Jose-4625/LAMP-BOX-ECO/README.md

# LAMP-BOX-ECO
## Loop-mediated Isothermal Amplification focused diagnostic ecosystem
Devices:
* LAMP-VIS
  * 3D printed Visualization box
* LAMP-BOX
  * Low-cost reaction Vessel for LAMP reactions
