Jose-4625/LAMP-BOX-ECO/VisBox/README.md

# LAMP Visualization Box

## Components
* 3D printed components
    * CE3_lampBOX circuit tray v1.gcode (Ender 3 specific gcode)
    * Upiece.stl
    * lampBOX circuit tray v1.stl
    * slider.stl
    * VisBox.stl
* 5V/12V breadboard powersupply
* small piece of insulated wire
* 4 x 100ohm Resistors
* 4 x Clear Blue LEDs
* 6cm x 8cm prototyping PCB
* Light filter gels
    * 2 x orange gel
    * 1 x yellow gel
* Sticky tape
## Links to components
* [100 ohm Resistors](https://www.amazon.com/100-Ohm-Resistors-Watt-Pieces/dp/B07JJQY958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)
* [Breadboard Powersupply](https://www.amazon.com/HiLetgo-Supply-Module-Prototype-Breadboard/dp/B00HJ6AE72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)
* [UV/Blue LEDs](https://www.amazon.com/microtivity-IL041-Clear-Blue-Pack/dp/B004JO4JPA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)
* [prototype PCB](https://www.amazon.com/Lheng-Double-Sided-Prototyping-Universal-Electronic/dp/B07PCQYV4M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)
## Tools
* Wire cutters
* Soldering Iron

## Assembly Instructions
1. 3D print a single copy of all items (STL files)
2. You should end with 5 3D printed pieces
    * VisBox Body
    * VisBox Top
    * U-piece
    * Slider
    * Circuit tray
3. gather your electronic components:
    * 1 x 5V/12V breadboard powersupply
    * 1 x small piece of insulated wire
    * 4 x 100ohm Resistors
    * 4 x Clear Blue LEDs
    * 1 x (6cm x 8cm) prototyping PCB
4. Along one of the short sides of the PCB, press fit the breadboard powersupply into the PCB perforations so that the pins closest to the edge are 3 holes from the edge
    * if the bottom pins bend its okay, the hole spacing is slightly different from the pin spacing
5. Take note of which pins on the bottom are ground and which pins are positive, pins of the same polarity are aligned
6. Following the PCB holes inline with the positive pins, with the LED on the same side as the powersupply, place the longer leg of an LED in the aligned hole, at least 5 holes from the pin (when looking underneath)
    * Skip 3 holes and place another LED inline with the first
    * Skip 2 holes and place another LED inline with the others
    * Skip 3 holes and place another LED inline with the others
    * See image for top view
7. To keep LEDs in place while soldering, feed the negative (short) leg of the LED back to the the powersupply side of the PCB and fold it (See top view)
8. Solder the power supply pins which are farthest from the LEDS to the PCB (See bottom view)
    * Ensure that the powersupply is securely soldered to the PCB
9. Fold the LED legs that are aligned with the positive pin towards the positive pin (See bottom view)
    * the length of the legs should cause overlap, this overlap will be used to connect the LEDs
10. Solder the overlapping legs of the LEDs and solder the leg closest to the powersupply to the positive pin
11. Pass one leg a resistor through each of the loops made by passing the negative lead of the LED to the front of the PCB
    * See bottom view
12. Solder the looped resistor leg to the LED leg it is passing under
13. Cut off the extra material of the soldered resistor leg
14. Bend the other legs of the resistors at 90 degree angles towards the powersupply
15. Solder the at the overlap of the legs
16. Solder the leg closest to the powersupply pins to the negative pin
    * If the last leg of of the LEDs is too short to reach the pin, add a piece of wire between the end of the resistor leg and the negative pin
17. Assemble the 3D-printed parts by first placing the lower box portion on a flat surface and them placing the lip on top
18. With the lid on top, attached the U-piece to the lid by either glueing or using a soldering iron to weld the lid ans U-piece together.
    * Ensure that the slider piece and move freely in and out of the U-piece while the lid and U-piece are bing attached
19. Align the holes on the bottom of the box to the LEDs on the PCB and use tape to secure and level the box
20. Create the proper light filter by cutting out 2 orange filters and 1 yellow filter so that they cover the viewport on the side of the box
    * Layer the filters: Orange-Yellow-Orange
21. Finally, set the powersupply to 5V using the jumper on the board, slide the PCB into the circuit tray with the inputs going under the hood and attach a power source to the powersupply board, either USB or 12V barrel jack!

## Reference Images
### Top View
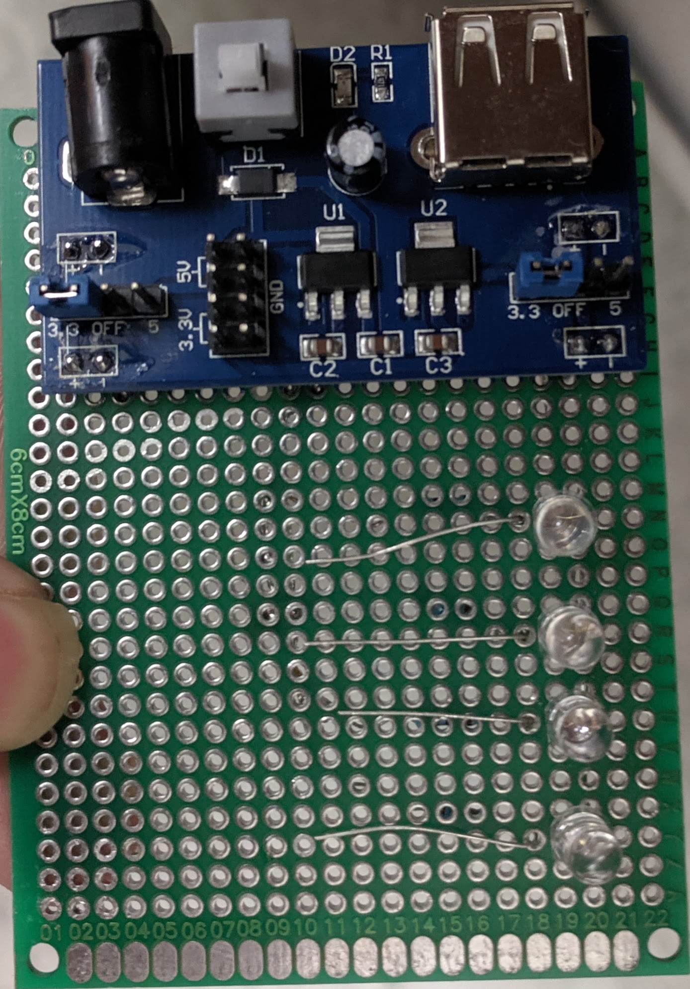
[picture p1: VisBox/top.jpg]
Top View

### Bottom View
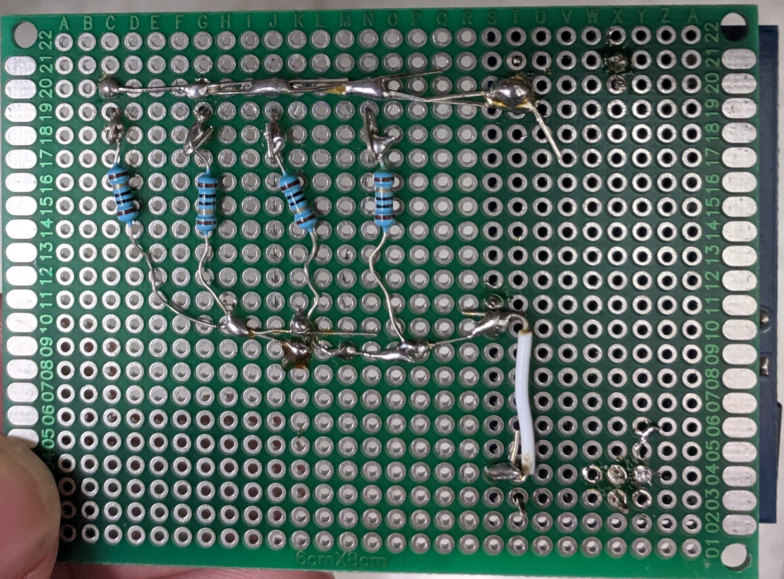
[picture p2: VisBox/bottom.jpg]
Bottom View

### Circuit Diagram
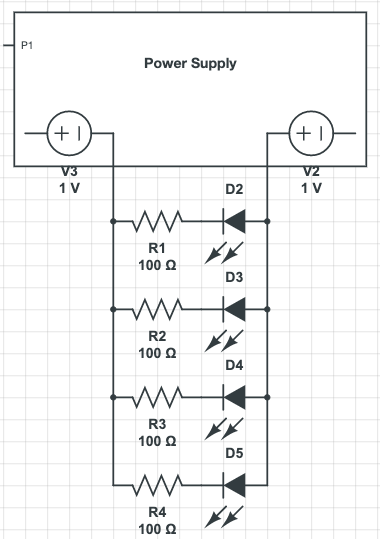
[picture p3: VisBox/circuitDiagram.png]
Circuit
