Jose-4625/LAMP-BOX-ECO/VisBox/VisBox.stl

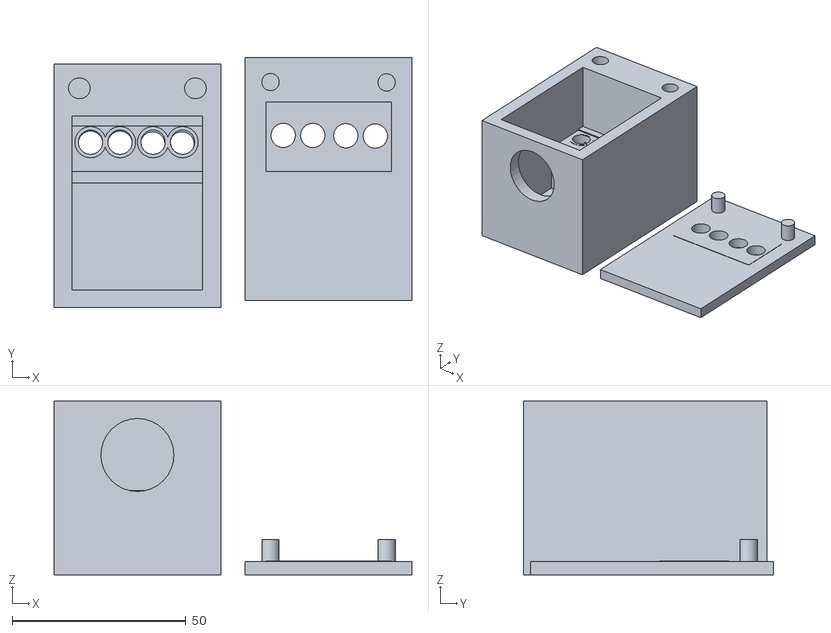
[picture p4: CAD file, 2020-01-21]
VisBox/VisBox.stl
103.0 x 71.8 x 50.0
