Jose-4625/LAMP-BOX-ECO/VisBox/lampBOX circuit tray v1.stl

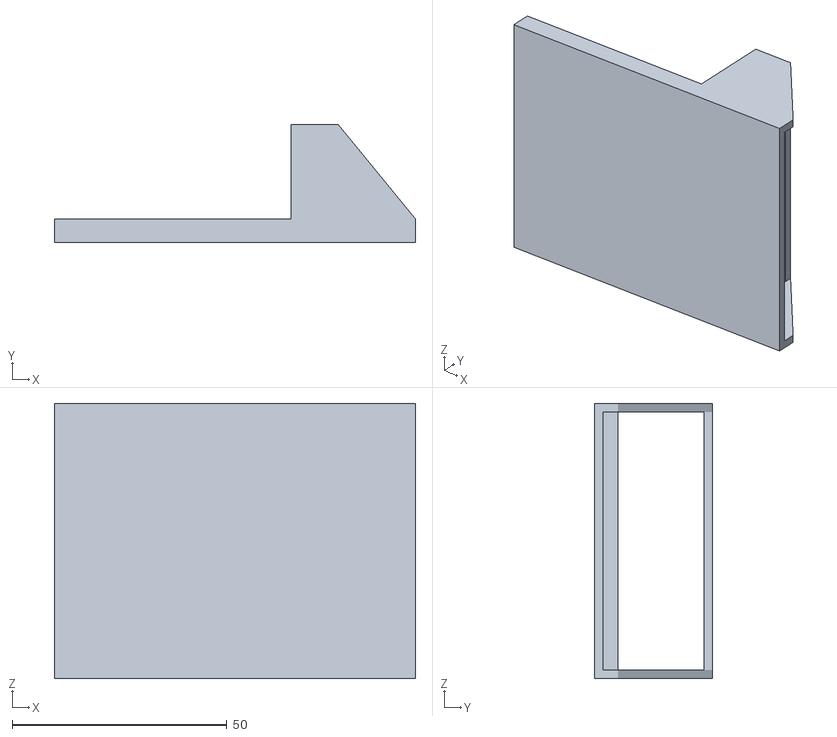
[picture p5: CAD file, 2019-11-22]
VisBox/lampBOX circuit tray v1.stl
84.0 x 27.5 x 64.0
