Jose-4625/LAMP-BOX-ECO/VisBox/Upiece.stl

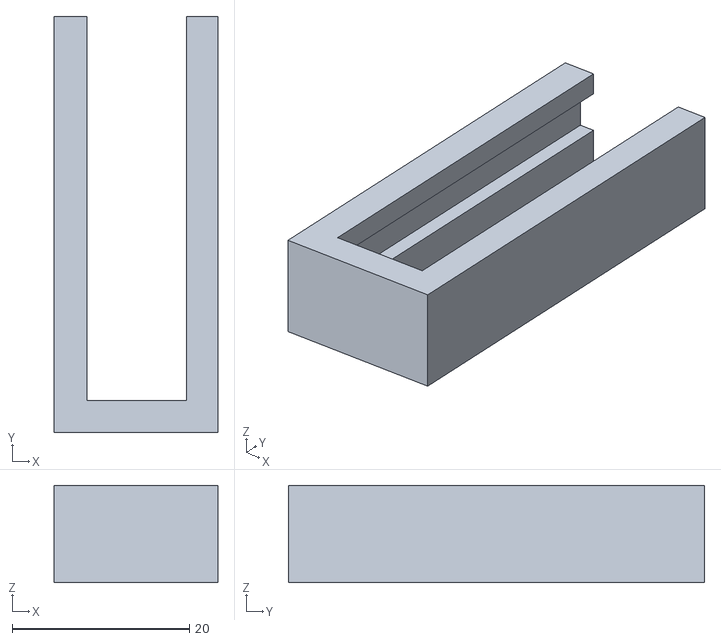
[picture p6: CAD file, 2019-11-22]
VisBox/Upiece.stl
18.5 x 47.0 x 11.0
