Jose-4625/LAMP-BOX-ECO/VisBox/slider.stl

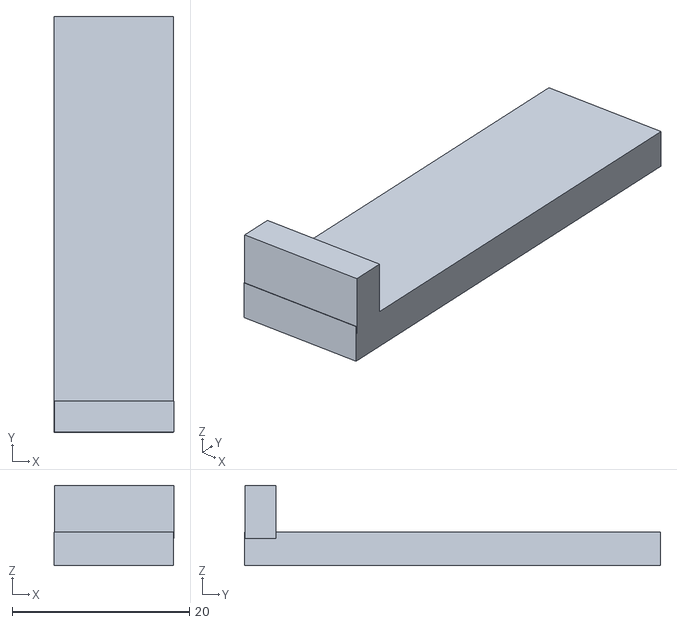
[picture p7: CAD file, 2019-11-22]
VisBox/slider.stl
13.6 x 47.0 x 9.05
