Jose-4625/LAMP-BOX-ECO/workSpace/singletonType.py

class singleton(type):
    """CPython Singleton Implementation"""
    _instances = {}
    def __call__(cls, *args, **kwargs):
        if cls not in cls._instances:
            cls._instances[cls] = super(singleton, cls).__call__(*args, **kwargs)
        return cls._instances[cls]

class uSingleton(object):
    """Micropython Singleton Implementation"""
    def __new__(cls, *args, **kwds):
        self = "__self__"
        if not hasattr(cls, self):
            instance = object.__new__(cls)
            instance.init(*args, **kwds)
            setattr(cls, self, instance)
        return getattr(cls, self)

    def init(self, *args, **kwds):
        pass
