Jose-4625/LAMP-BOX-ECO/(commit log)

2019-11-06 fixed json compatibility interface
    [RoutineInterfaceDataModel.py]
2019-11-22 added mpy_cross compiler to workflow
    [Upiece.stl, lampBOX circuit tray v1.stl, slider.stl]
2019-11-25 implemented and tested micropython PID Controller
2020-01-07 implemented interfaces between threads, and system output to user
2020-01-07 implemented interface functions between threads and system output to user
2020-01-09 Upload New File
    [VisBox.stl]
2020-01-17 Updated assembly instructions
2020-01-17 Added Circuit Diagram
2020-01-17 Added fake machine class to emulate ESP32 hardware
2020-01-20 Implemented PID temperature sampling, Next step is output
2020-01-21 Implemented AP connections to MWS2 server and corrected types error
    [LAMP.py, buildFS.py]
2020-01-30 fixed web interface bug
    [LAMP.py]
